evolutek/lib-elec/3D/Board/Adafruit PA1616D/Adafruit PA1616D.stp

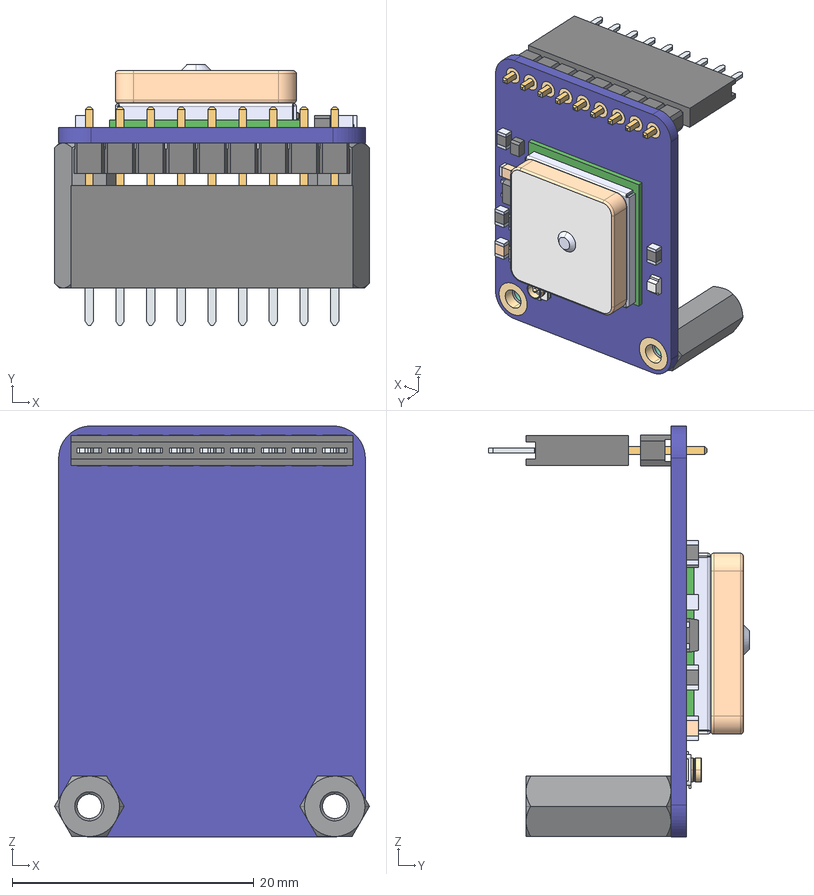
[picture p1: CAD file, 2026-01-28]
3D/Board/Adafruit PA1616D/Adafruit PA1616D.stp
26.1 x 21.6 x 34.0 mm
ADA746
6130xx11821_PIN x 9
6130xx11121_PIN x 9
