evolutek/lib-elec/3D/Components/30x30x10 DC Fan.STEP

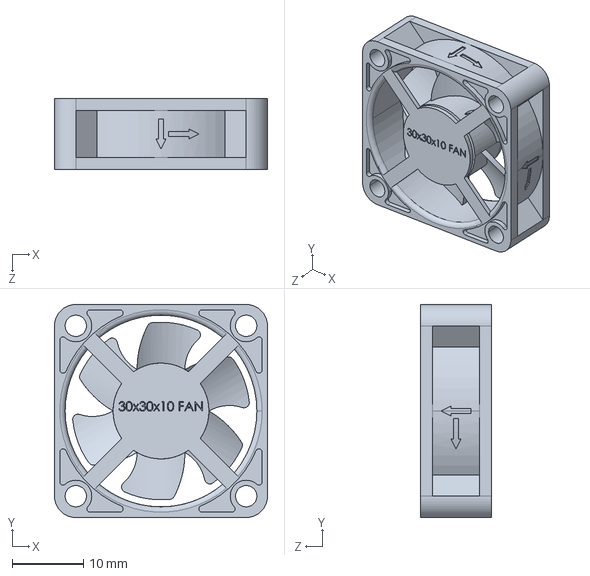
[picture p2: CAD file, 2026-03-21]
3D/Components/30x30x10 DC Fan.STEP
30.0 x 30.0 x 10.0 mm
