evolutek/lib-elec/3D/Components/Download_STP_831025559 (rev1).stp

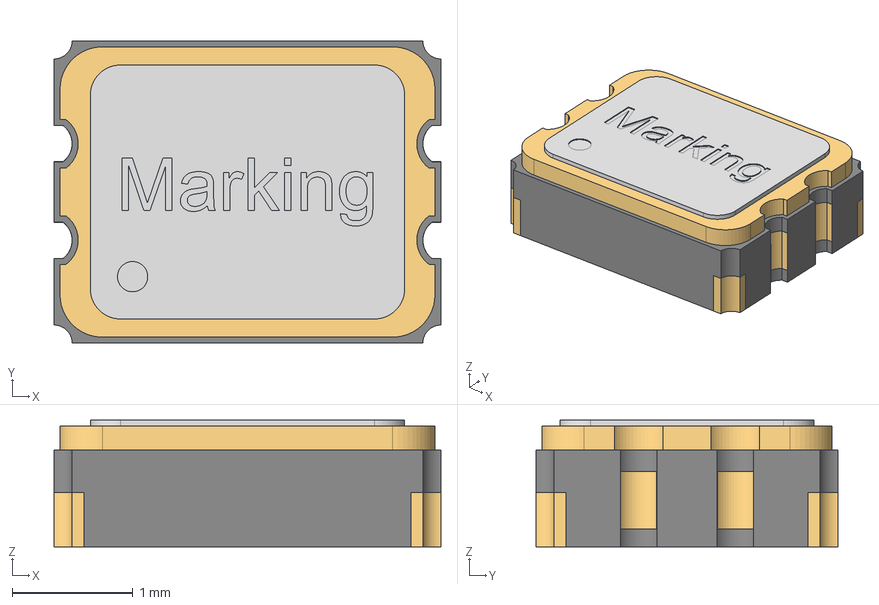
[picture p3: CAD file, 2026-03-21]
3D/Components/Download_STP_831025559 (rev1).stp
3.20 x 2.50 x 1.05 mm
Pins
Cover
