evolutek/lib-elec/3D/Components/TPS2121RUXR.step

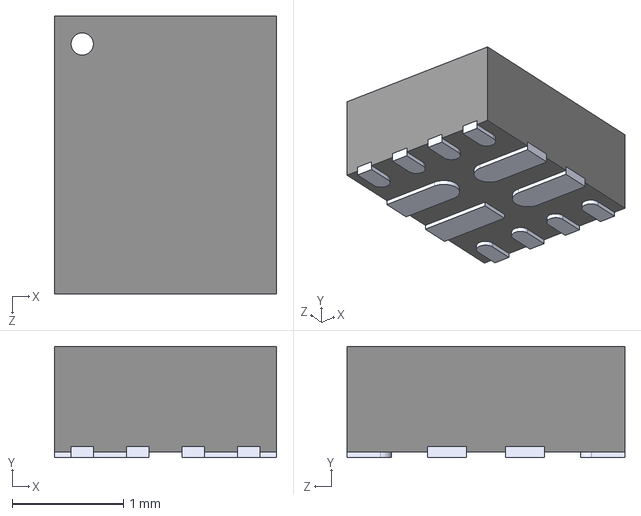
[picture p4: CAD file, 2026-01-28]
3D/Components/TPS2121RUXR.step
2.00 x 1.00 x 2.50 mm
