evolutek/lib-elec/3D/Connectors/Download_STEP_632722110112 (rev1).stp

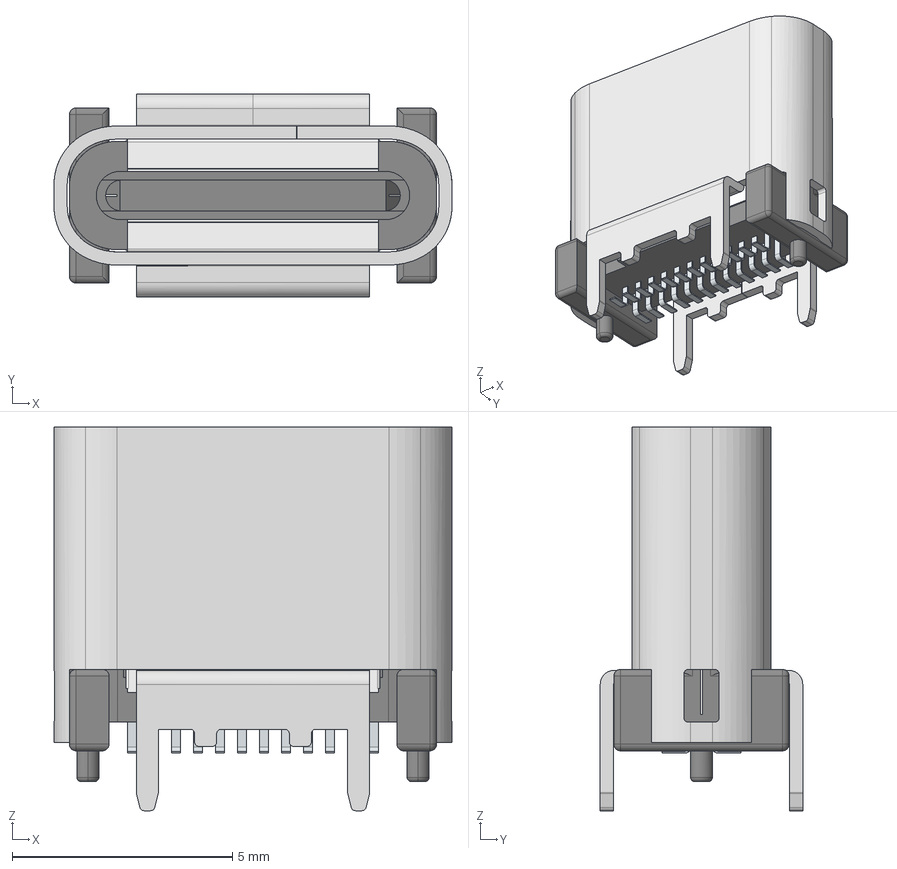
[picture p5: CAD file, 2026-03-01]
3D/Connectors/Download_STEP_632722110112 (rev1).stp
9.04 x 4.60 x 8.71 mm
632722110112_Shielding
632722110112_Housing
632722110112_Shielding_2 x 2
632722110112_Shielding_3 x 2
632722110112_Pin_1 x 4
632722110112_Pin_2 x 16
632722110112_Pin_3 x 4
