evolutek/lib-elec/3D/Components/S1325.stp

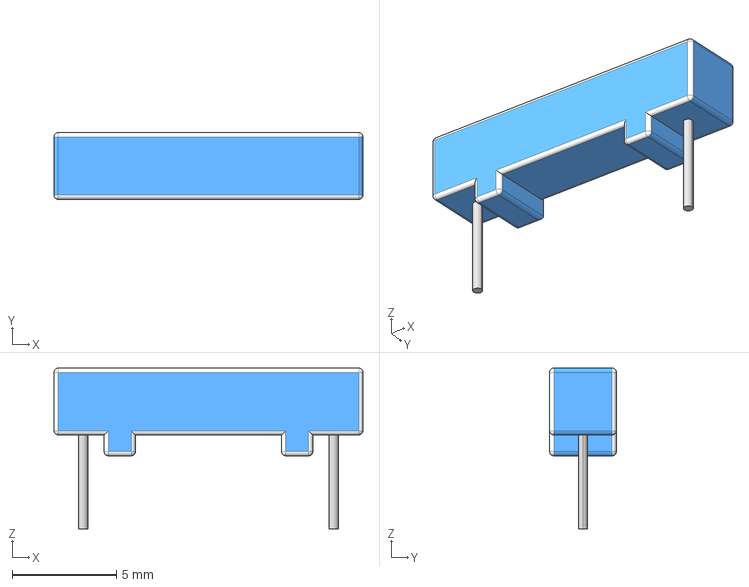
[picture p6: CAD file, 2025-07-01]
3D/Components/S1325.stp
14.8 x 3.20 x 7.70 mm
