evolutek/lib-elec/3D/Connectors/Download_STEP_686108188822 (rev1).stp

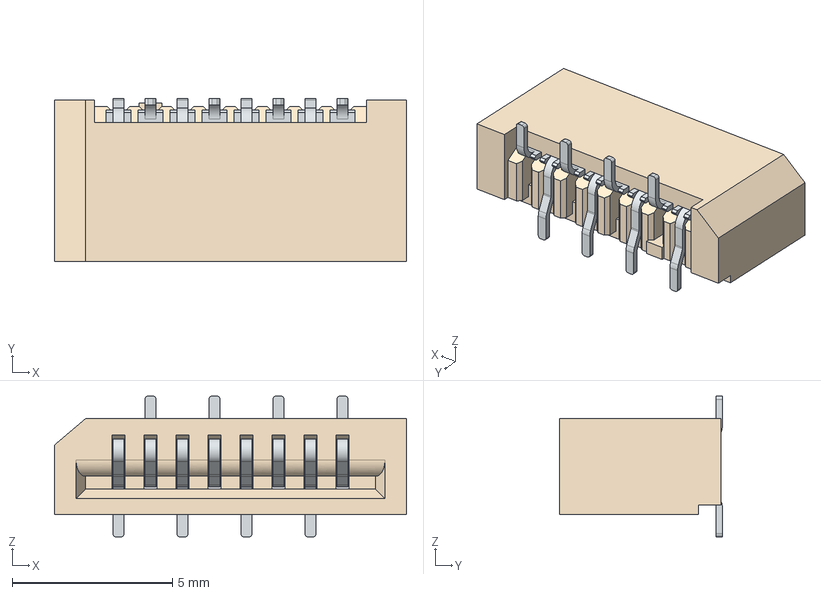
[picture p7: CAD file, 2026-03-01]
3D/Connectors/Download_STEP_686108188822 (rev1).stp
11.0 x 5.10 x 4.40 mm
6861xx188822_Pin1 x 4
6861xx188822_Pin2 x 4
