evolutek/lib-elec/3D/Components/STP_WL-ICLED_1312020030000 (rev1).stp

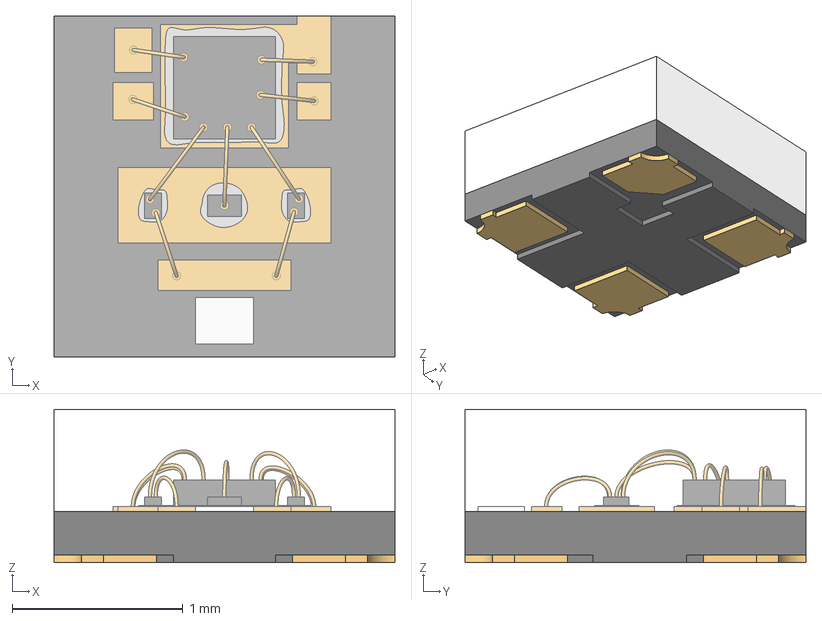
[picture p8: CAD file, 2025-07-01]
3D/Components/STP_WL-ICLED_1312020030000 (rev1).stp
2.00 x 2.00 x 0.9 mm
PCB
Contacts
Resin
