evolutek/lib-elec/3D/Connectors/BM09B-SRSS-TB-LF.STEP

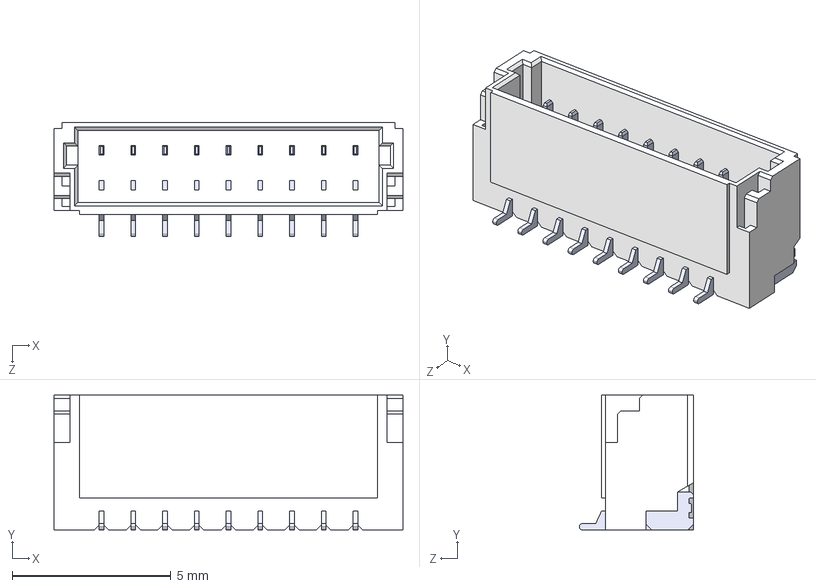
[picture p9: CAD file, 2026-01-28]
3D/Connectors/BM09B-SRSS-TB-LF.STEP
11.0 x 4.25 x 3.60 mm
