evolutek/lib-elec/3D/Components/BMP390.STEP

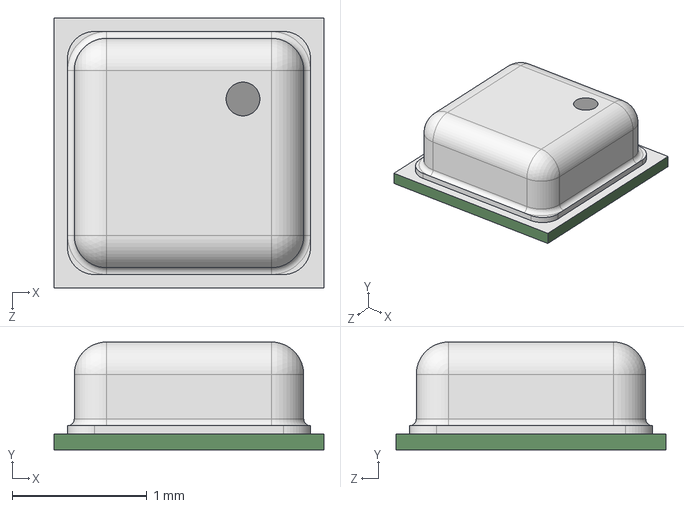
[picture p10: CAD file, 2025-07-01]
3D/Components/BMP390.STEP
2.00 x 0.8 x 2.00 mm
