evolutek/lib-elec/3D/Components/SMT-0540-S-R--3DModel-STEP-461651.STEP

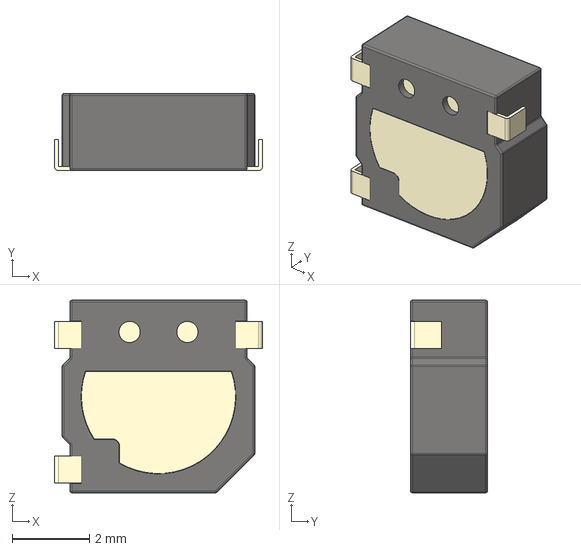
[picture p12: CAD file, 2025-07-01]
3D/Components/SMT-0540-S-R--3DModel-STEP-461651.STEP
5.40 x 2.00 x 5.00 mm
