evolutek/lib-elec/3D/Components/Download_STEP_463092370402 (rev1).stp

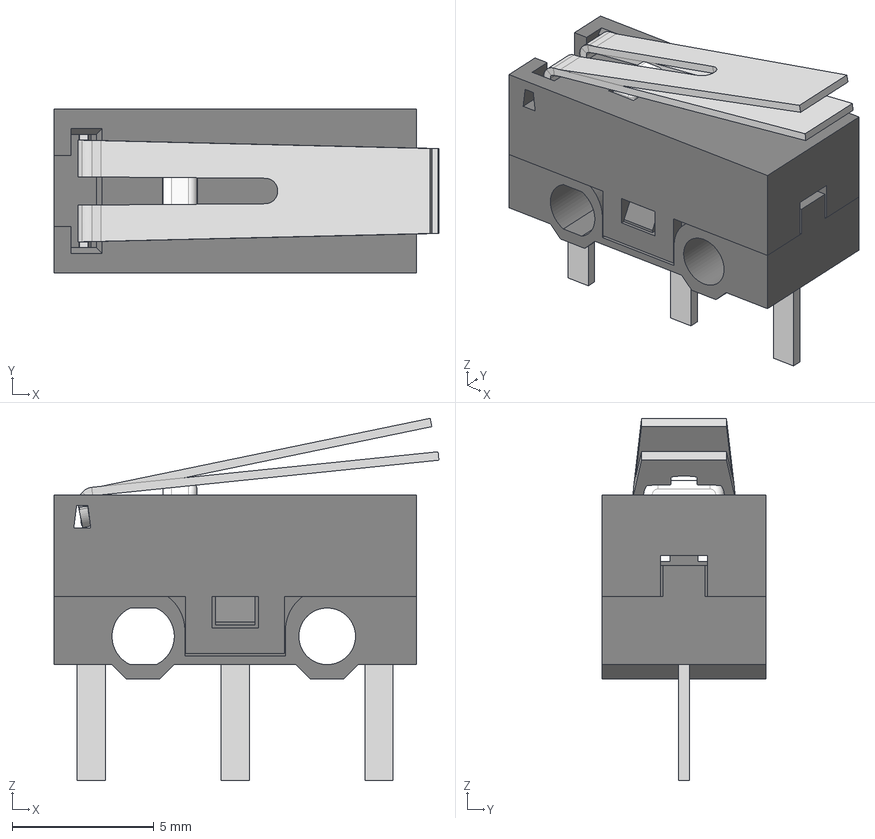
[picture p13: CAD file, 2025-05-14]
3D/Components/Download_STEP_463092370402 (rev1).stp
13.6 x 5.80 x 12.8 mm
Base
Terminal x 3
Straight_lever x 2
Button x 2
Cover
