evolutek/lib-elec/3D/Connectors/TSM-103-01-F-SH.stp

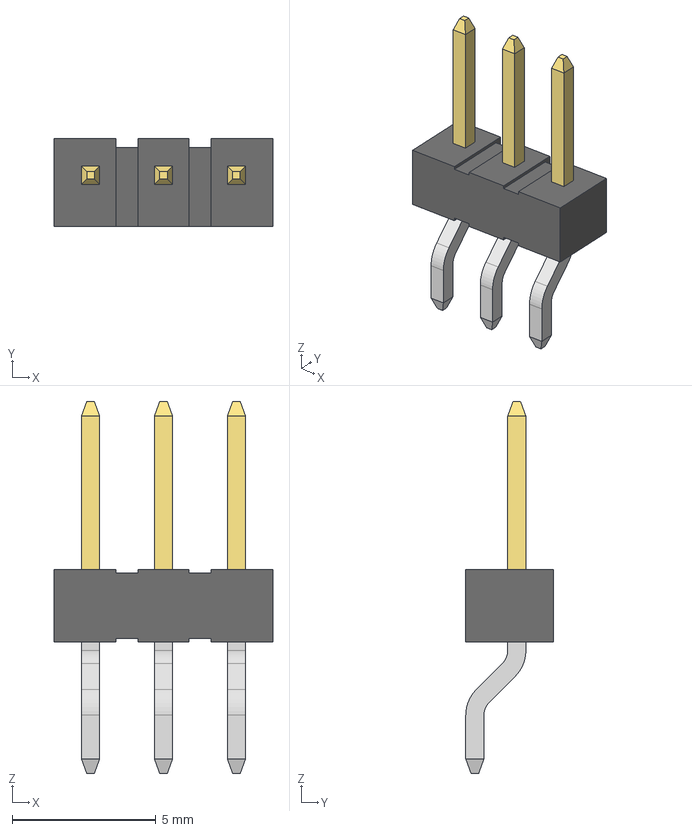
[picture p14: CAD file, 2025-03-21]
3D/Connectors/TSM-103-01-F-SH.stp
7.62 x 3.05 x 13.0 mm
TSM-103-01-SH_body
T-1S6-08-F(-01-3-SH)
T-1S6-08-F(-01-3-SH)2
