evolutek/lib-elec/3D/Connectors/CONN-SMD_18K314305.step

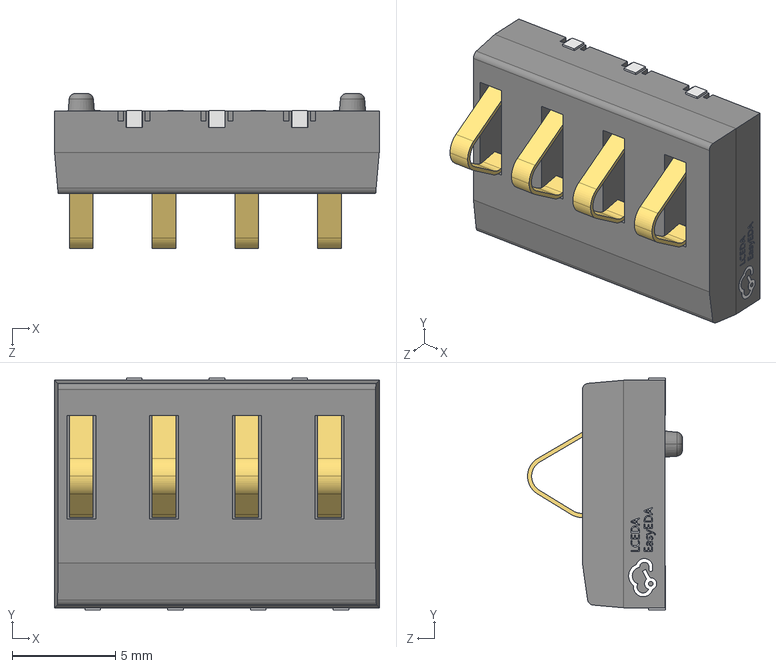
[picture p15: CAD file, 2025-03-15]
3D/Connectors/CONN-SMD_18K314305.step
15.7 x 11.2 x 7.49 mm
