evolutek/lib-elec/3D/Connectors/690367280876 (rev1).stp

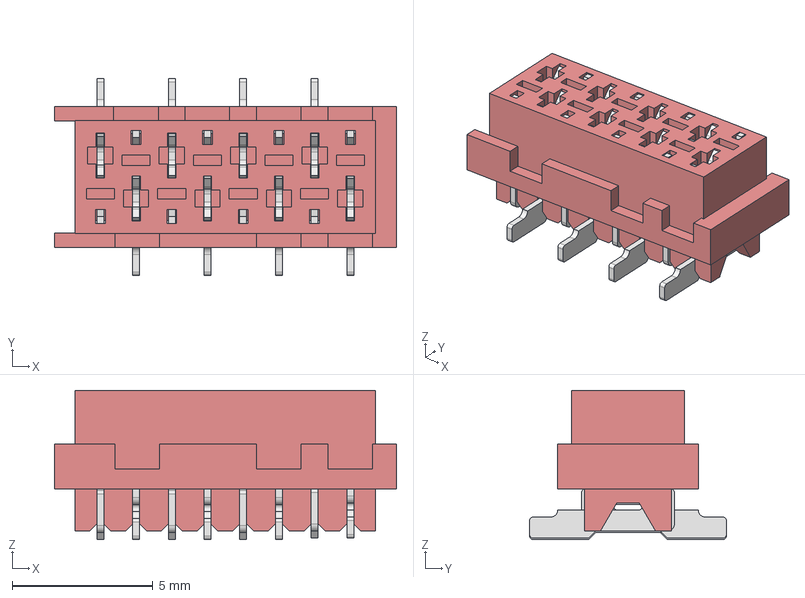
[picture p16: CAD file, 2026-03-09]
3D/Connectors/690367280876 (rev1).stp
12.2 x 7.00 x 5.30 mm
69036728xx76_PIN x 8
