evolutek/lib-elec/3D/Connectors/614105150721 (rev1).stp

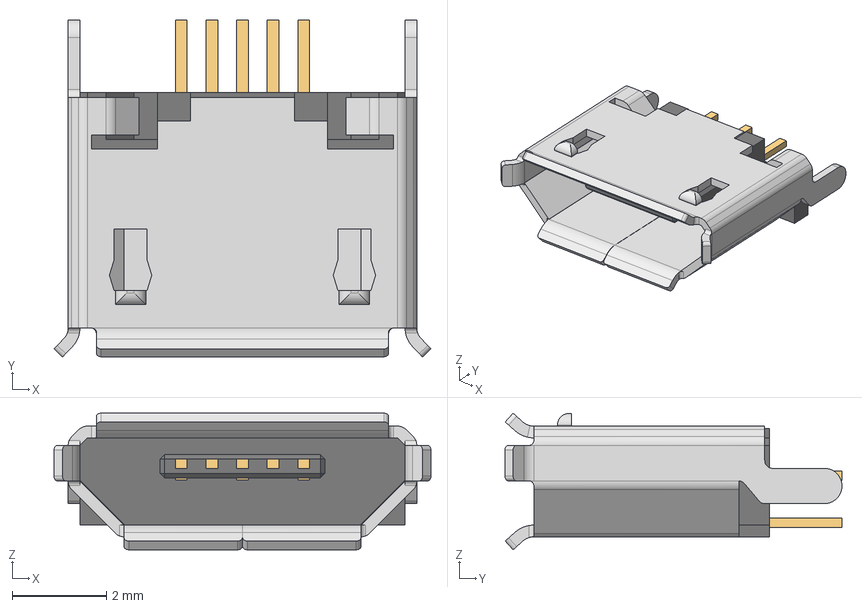
[picture p17: CAD file, 2026-03-06]
3D/Connectors/614105150721 (rev1).stp
8.00 x 7.15 x 2.90 mm
614105150721_Housing
614105150721_Pin1 x 3
614105150721_Pin2 x 2
614105150721_Shielding
