evolutek/lib-elec/3D/Connectors/690367280676 (rev1).stp

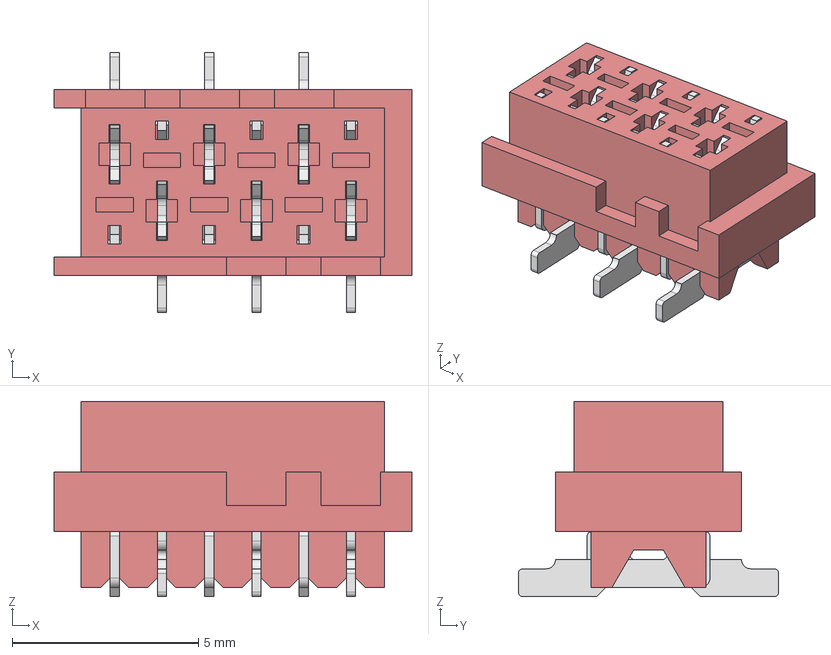
[picture p18: CAD file, 2026-01-28]
3D/Connectors/690367280676 (rev1).stp
9.62 x 7.00 x 5.25 mm
69036728xx76_PIN x 6
