evolutek/lib-elec/(list of files, cad)

Other CAD files:
3D/Board/Adafruit PA1616D/Adafruit PA1616D.CATProduct
3D/Board/Adafruit PA1616D/src/61300911121.CATPart
3D/Board/Adafruit PA1616D/src/61300911821 (rev1).CATProduct
3D/Board/Adafruit PA1616D/src/61300911821.CATPart
3D/Board/Adafruit PA1616D/src/6130xx11121_PIN.CATPart
3D/Board/Adafruit PA1616D/src/6130xx11821_PIN.CATPart
3D/Board/Adafruit PA1616D/src/ADA746.CATPart
3D/Board/Adafruit PA1616D/src/Download_STEP_970120151 (rev1).CATPart
3D/Board/Adafruit PA1616D/src/Download_STP_61300911121 (rev1).CATProduct
3D/Board/Raspberry Pi Zero W/Src/61004021821/61004021821 (rev1).CATProduct
3D/Board/Raspberry Pi Zero W/Src/61004021821/61004021821.CATPart
3D/Board/Raspberry Pi Zero W/Src/61004021821/6100xx21821_PIN.CATPart
3D/Board/Raspberry Pi Zero W/Src/9774100151R.CATPart
3D/Board/Raspberry Pi Zero W/Src/Raspberry Pi Zero W/Raspberry PI Zero W SMD.CATProduct
3D/Board/Waveshare 1.5 inch OLED/1.5 inch OLED/1_5INCH-128X128-QLED.CATPart
3D/Board/Waveshare 1.5 inch OLED/1.5 inch OLED/1_5inch_oled_module.CATProduct
3D/Board/Waveshare 1.5 inch OLED/1.5 inch OLED/2_1_200.CATPart
3D/Board/Waveshare 1.5 inch OLED/1.5 inch OLED/3_1_2_A.CATPart
3D/Board/Waveshare 1.5 inch OLED/1.5 inch OLED/5_1_2_A.CATPart
3D/Board/Waveshare 1.5 inch OLED/1.5 inch OLED/BOARD.CATPart
3D/Board/Waveshare 1.5 inch OLED/1.5 inch OLED/CAPC1608_0603_.CATPart
3D/Board/Waveshare 1.5 inch OLED/1.5 inch OLED/CAPC2012_0805_.CATPart
3D/Board/Waveshare 1.5 inch OLED/1.5 inch OLED/HP2_0-7PIN-SMT.CATPart
3D/Board/Waveshare 1.5 inch OLED/1.5 inch OLED/INDC3225_1210_.CATPart
3D/Board/Waveshare 1.5 inch OLED/1.5 inch OLED/RESC1608_0603_.CATPart
3D/Board/Waveshare 1.5 inch OLED/1.5 inch OLED/SOD323.CATPart
3D/Board/Waveshare 1.5 inch OLED/1.5 inch OLED/SOT23-5AND6__100.CATPart
3D/Board/Waveshare 1.5 inch OLED/1.5 inch OLED/SOT23-6-7933_AF0.CATPart
3D/Board/Waveshare 1.5 inch OLED/1.5 inch OLED/SW3DPS-3-LEAD_SOT23-3.CATPart
3D/Board/Waveshare 1.5 inch OLED/1.5 inch OLED/SW3DPS-DO-214AC_SMA.CATPart
3D/Board/Waveshare 1.5 inch OLED/1.5 inch OLED/USER_LIBRARY-TSOT-23-6_S6_.CATPart
3D/Board/Waveshare 1.5 inch OLED/1.5 inch OLED/_1_1_20001.CATPart
3D/Board/Waveshare 1.5 inch OLED/1.5 inch OLED/_2_1_20001.CATPart
3D/Board/Waveshare 1.5 inch OLED/1.5 inch OLED/_7_AF0.CATPart
3D/Board/Waveshare 1.5 inch OLED/Others/61300811121 (rev1).CATProduct
3D/Board/Waveshare 1.5 inch OLED/Others/61300811121.CATPart
3D/Board/Waveshare 1.5 inch OLED/Others/61300815721 (rev1).CATProduct
3D/Board/Waveshare 1.5 inch OLED/Others/61300815721.CATPart
3D/Board/Waveshare 1.5 inch OLED/Others/6130xx11121_PIN.CATPart
3D/Board/Waveshare 1.5 inch OLED/Others/6130xx15721_PIN.CATPart
3D/Board/Waveshare 1.5 inch OLED/Others/9774080360R.CATPart
3D/Board/Waveshare 1.5 inch OLED/Others/Vis Bombee M3x6mm.CATPart
3D/Board/Waveshare 1.5 inch OLED/Waveshare 1.5 inch OLED with 8mm spacers.CATProduct
3D/Components/428542320811 (rev1).stp
3D/Components/430156050736 (rev1).stp
3D/Components/7347296.stp
3D/Components/7488910092 (rev1).stp
3D/Components/S1325.CATPart
3D/Connectors/0022035025.stp
3D/Connectors/66201021022 (rev1).stp
3D/Connectors/690367280476 (rev1).stp
3D/Connectors/690367281076 (rev1).stp
3D/Connectors/690367281276 (rev1).stp
3D/Connectors/690367281476 (rev1).stp
3D/Connectors/690367281676 (rev1).stp
3D/Connectors/79527141 (rev1).stp
