evolutek/lib-elec/(commit log)

2024-08-08 added symbol
    footprint exists in kicad's standard library, but needs a 3D model
2025-03-15 Add 18K314305
    [CONN-SMD_18K314305.step]
2025-03-15 minor fix
    removed silkscreen marking from under the logos
2025-03-15 Add 430156050736
    [430156050736 (rev1).stp]
2025-03-21 Add TSM-103-01-F-SH
    [TSM-103-01-F-SH.stp]
2025-04-26 Add 463092370402
    [Download_STEP_463092370402 (rev1).stp]
2025-04-26 Finish Power Switch RS SPDT Angled
    [7347296.stp]
2025-05-09 Add 42854232081X
    [428542320811 (rev1).stp]
2025-06-11 added 14 pins WR MM connector
    [690367281476 (rev1).stp]
2025-06-11 made pin 1 indicator bigger on BNO085
2025-06-11 added WR-MM 16 pins
    [690367281676 (rev1).stp]
2025-06-11 Add SSD1306
    [OLED_0.91_128x32.stp]
2025-06-11 Add S135 reed sensor
    [S1325.CATPart, S1325.stp]
2025-06-11 Add Raspberry Pi Zero W SMD
    [61004021821 (rev1).CATProduct, 61004021821.CATPart, 6100xx21821_PIN.CATPart, 61304021821 (rev1).stp, 970100155.CATPart, Raspberry PI Zero W SMD.CATProduct, microsd-card.stp]
2025-06-11 Replace spacers by SMD ones
    [970100155.CATPart, 9774100151R.CATPart, Raspberry PI Zero W SMD.CATProduct]
2025-06-11 Add 7488910092
    [7488910092 (rev1).stp]
2025-06-24 Add RGB Led: 1312020030000
    [STP_WL-ICLED_1312020030000 (rev1).stp]
2025-06-24 Add 22-03-5025
    [0022035025.stp]
2025-06-24 Add 79527141
    [79527141 (rev1).stp]
2025-06-30 Add XDCR_SMT-0540-S-R
    [SMT-0540-S-R--3DModel-STEP-461651.STEP]
2025-12-04 Upgrade schematics
2026-01-28 add Adafruit PA1616D
    Add component Adafruit PA1616D (symbol, footprint,3D)
    [Adafruit PA1616D.CATPart, Adafruit PA1616D.stp]
2026-01-28 Update PA1616D footprint
    [61300911121.CATPart, 61300911821 (rev1).CATProduct, 61300911821.CATPart, 6130xx11121_PIN.CATPart, 6130xx11821_PIN.CATPart, ADA746.CATPart, Adafruit PA1616D.CATPart, Adafruit PA1616D.CATProduct]
2026-01-28 change Mounting holes
2026-01-28 Clean WR-MM 4/6/16 3d models
    [690367280476 (rev1).stp, 690367280676 (rev1).stp, 690367281676 (rev1).stp]
2026-01-28 Add TPS2121
    [TPS2121RUXR.step]
2026-01-28 Update 690367281076 3D model
    [690367281076 (rev1).stp]
2026-01-28 Add 690367281276
    [690367281276 (rev1).stp]
2026-01-28 Update 40x40 Fan
2026-01-28 Add 62001021022 footprint
    [66201021022 (rev1).stp]
2026-01-28 Add Waveshare 1.5 inch OLED
    [1_5INCH-128X128-QLED.CATPart, 1_5inch_oled_module.CATProduct, 2_1_200.CATPart, 3_1_2_A.CATPart, 5_1_2_A.CATPart, 61300811121 (rev1).CATProduct, 61300811121.CATPart, 61300815721 (rev1).CATProduct]
2026-01-28 Add BM09B-SRSS
    [BM09B-SRSS-TB-LF.STEP]
2026-01-28 Remove bad footprint and update 9774110360
2026-01-28 Fix 690367281476 3d model
    [690367281476 (rev1).stp]
2026-01-28 Add 632722110112 footprint and 3d model
    [Download_STEP_632722110112 (rev1).stp]
2026-01-28 Add 686108188822
    [Download_STEP_686108188822 (rev1).stp]
2026-02-05 Add footprints type
2026-02-05 Update 1313210530000 footprint
2026-03-01 Update 686108188622 footprint
2026-03-06 Add 614105150721 footprint
    [614105150721 (rev1).stp]
2026-03-09 Clean 690367280876 3D model
    [690367280876 (rev1).stp]
2026-03-21 Add 831026068 and CAN FD Trancsievers
    [Download_STP_831026068 (rev1).stp]
2026-03-21 Add 30x30 Fan, replace 831026068 by 831025559
    [30x30x10 DC Fan.STEP, Download_STP_831025559 (rev1).stp, Download_STP_831026068 (rev1).stp]
