evolutek/lib-elec/(notices)

Notices in the files:
3D/Connectors/TSM-103-01-F-SH.stp:
author */ ('License CC BY-ND 4.0'),
